lylemoffitt/Sr-Design/Project Materials/Media/CAD Final Moc.png

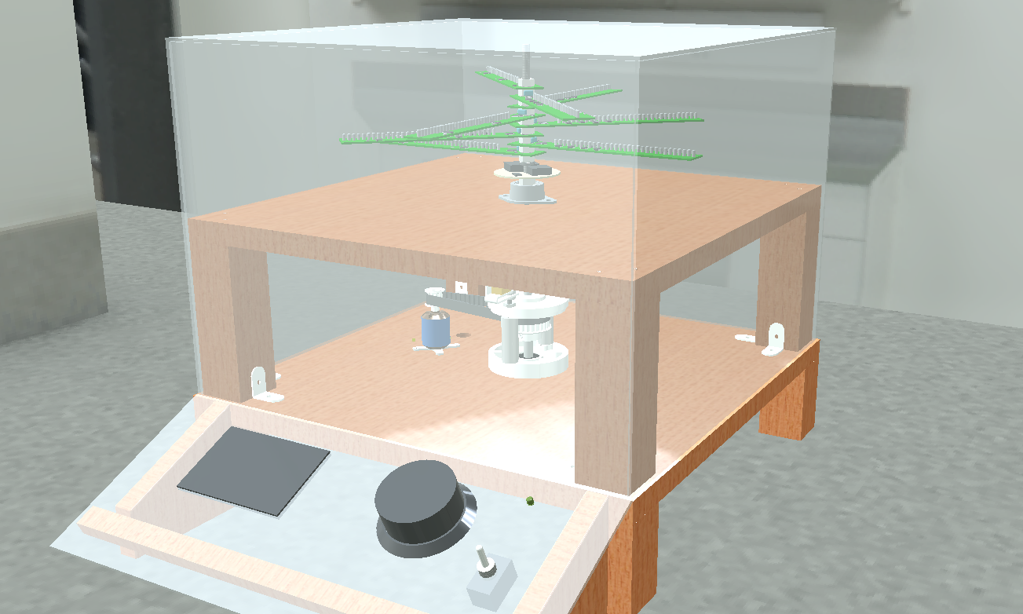
Project Materials/Media/CAD Final Moc.png
