lylemoffitt/Sr-Design/Project Materials/Media/CAD Moc.png

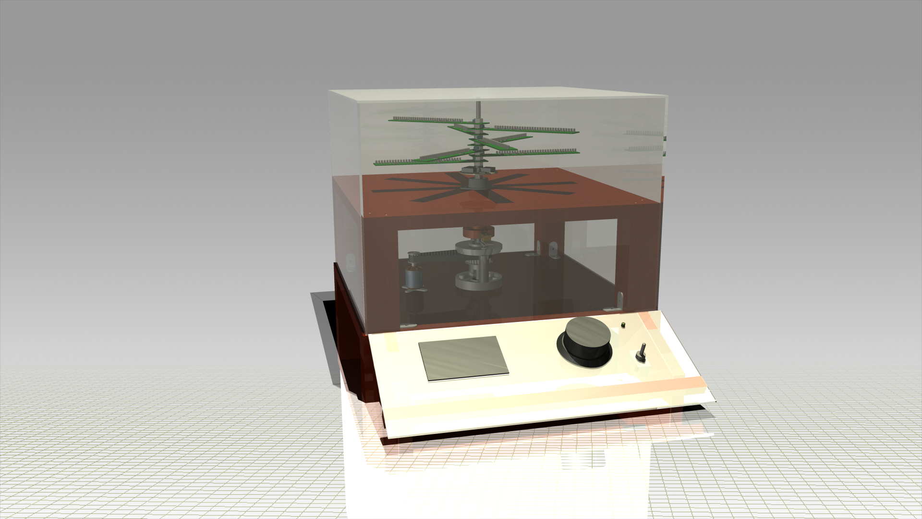
Project Materials/Media/CAD Moc.png
