lylemoffitt/Sr-Design/Project Materials/Planning Materials/Senior Design - Item Priority Check List.xlsx

 | Item | Priority | Time Frame | Decision | Notes
 | New Power Electronics | Medium | Soon
 | 40A ESC | Low | Done
 | New Hall Effect Sensor | Medium | Soon
PCB | Finalize Schematic [on paper] | High | ASAP
 | Arduino - Built in vs. not | High | Soon | TBD
LEDs | Number of (16,32,48) | Low | Done | 32 | Need to Consider Power Draw - We do have a 12V, 6A supply available in lab
 | Type of | Low | Done | 3mm T-H
 | Number of z-layers | Low | Done | 8
 | Refine/clean/neaten platform | Low | Far Away
 | Plexiglass enclosure | High | Far Away
 | Mechanical Tweaks/Fixes | Medium | As Necessary
 | On board SD-Card | Low | Done | No
 | Wireless Communication | Low | Done | No
 | On board EEPROM | High | Soon | Probs
