lylemoffitt/Sr-Design/Project Materials/Documentation Materials/Proposal Outline.jpg

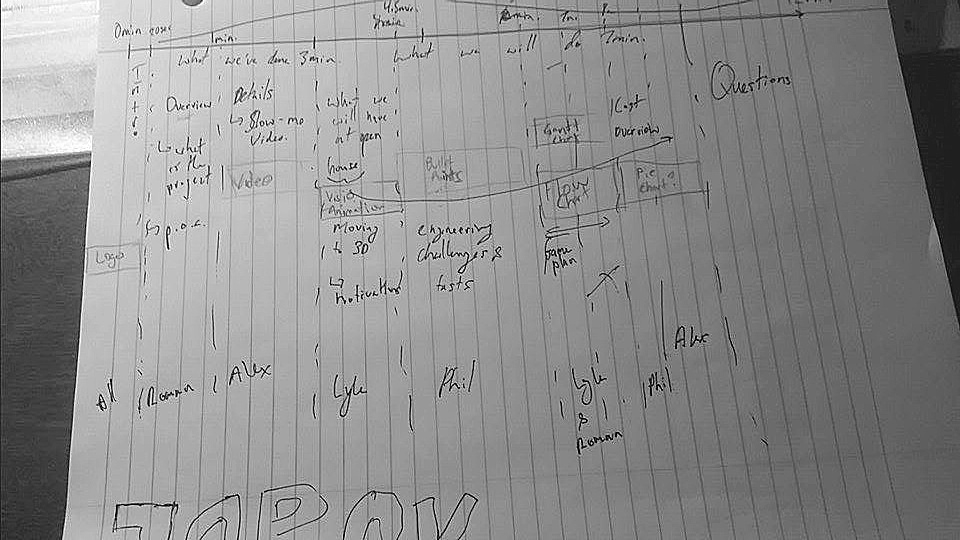
Project Materials/Documentation Materials/Proposal Outline.jpg
