lylemoffitt/Sr-Design/Project Materials/Reference Materials/LED wing schematic.png

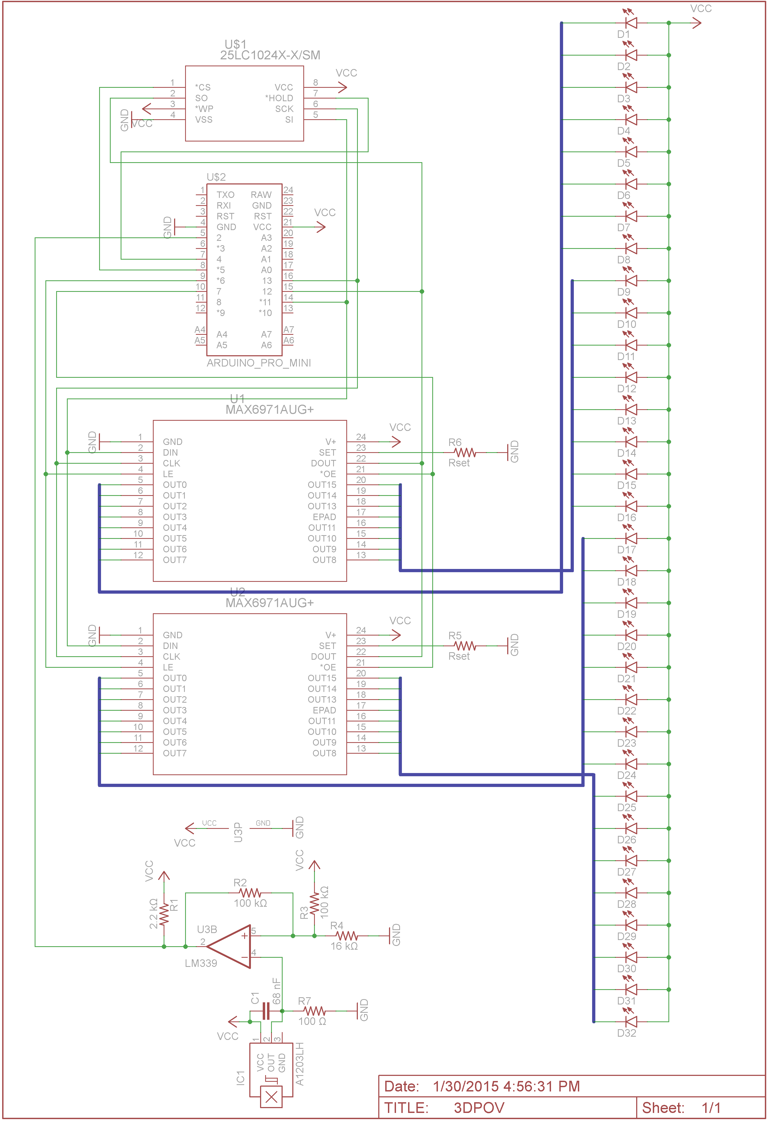
Project Materials/Reference Materials/LED wing schematic.png
