lylemoffitt/Sr-Design/Project Materials/Reference Materials/Schematic.png

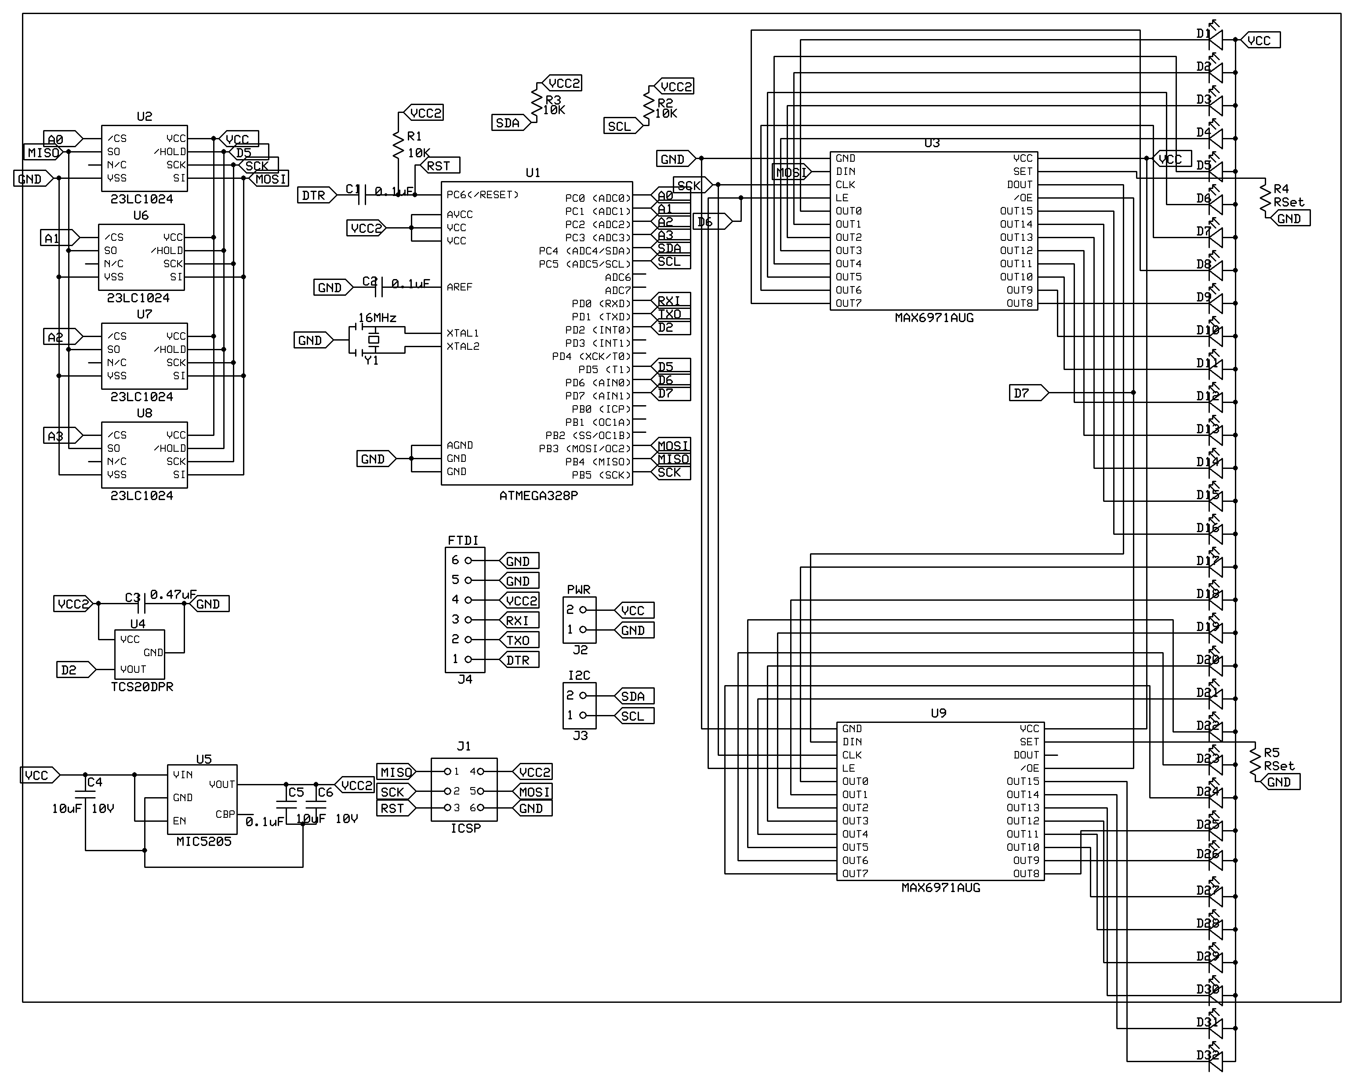
Project Materials/Reference Materials/Schematic.png
