lylemoffitt/Sr-Design/Project Materials/Documentation Materials/DataFlow.pptx

Import Source
Slice
Tool: Slic3r
Rasterize
Tool: Ghostscript
Source: Online
Type: application/vnd.ms-pki.stl
Type: image/svg+xml
Type: application/vnd.cups-raster
Transform
Cartesian to Polar
Scale resolution
Type: application/octet-stream
Transfer
SPI over RF
I2C to blades

Interrupt Source
Hardware Timer
Hall-Effect
I2C Tx/Rx
Reset Timer
Load Buffer From SRAM
Print LEDs From Buffer
Change SRAM Source
Load To SRAM
SPI Tx/Rx
Load SRAM
I2C Transfer
