lylemoffitt/Sr-Design/Project Materials/Planning Materials/ELE 491 Order Form.xlsx

Sheet: Sheet1
 |  | Group 3: Roman O., Alex J., Philip G., Lyle M.
 |  | ELE 491
 |  | 2014-10-15
 |  | Company website (http://www.digikey.com/)
 |  | McMastercarr.com
Number | Quantity | Part # | Part name | Cost | Sub Total
1 | 1 | 8312K72 | Super-Conductive 101 Copper | $35.24 | $35.24
 |  |  |  | Total | $35.24
 |  | Company website (http://www.digikey.com/)
 |  | Hobbyking.com
Number | Quantity | Part # | Part name | Cost | Sub Total
1 | 1 | D2836-11750 | Turnigy D2836/11 750KV Brushless Outrunner Motor | $13.40 | $13.40
 |  |  |  | Total | $13.40
 |  | Company website (http://www.digikey.com/)
 |  | sdp-si.com
Number | Quantity | Part # | Part name | Cost | Sub Total
1 | 1 | A 6A35M010DF1004 | 5 mm (T5) Pitch,10 Teeth, 4mm Bore, 2 Flanges/With Hub, Aluminum Alloy Timing Pulley for 10mm Wide Belt | $8.60 | $8.60
2 | 1 | A 6A55-026DF1512 | 5 mm (GT2) Pitch,26 Teeth, 0.375" Bore, 2 Flanges / With Hub, Aluminum Alloy Timing Pulley for .591 (15mm)" Wide Belt | $15.07 | $15.07
3 | 2 | A 6T35M061100 | 5 mm (T5) Pitch, 61 Teeth, 10mm wide Single Sided Polyurethane Belt with Steel Tensile Cords | $5.45 | $10.90
 |  |  |  | Total | $34.57
 |  | Company website
 |  | digikey.com
Number | Quantity | Part # | Part name | Cost | Sub Total
1 | 4 | MAX6971ANG+-ND (http://www.digikey.com/product-detail/en/MAX6971ANG%2B/MAX6971ANG%2B-ND/1512074) | 16-Port, 36V Constant-Current LED Driver | $5.25 | $21.00
 |  |  |  | Total | $21.00
 |  |  |  | Grand Total | $104.21

Sheet: Sheet2
 | Request for reimbursement
You need to get approval prior to purchasing, Use this form with updated prices to get reimbursted
 | Date: | Company: | Approved By:
 | 2014-02-05 | Midnight Electronics
 |  |  |  | Estimated
Number | Quantity | Part # | Part name | Cost | Sub Total
1
2 |  |  |  |  | $0.00
3 |  |  |  |  | $0.00
4 |  |  |  |  | $0.00
5 |  |  |  |  | $0.00
6 |  |  |  |  | $0.00
7 |  |  |  |  | $0.00
8 |  |  |  |  | $0.00
9 |  |  |  |  | $0.00
10 |  |  |  |  | $0.00
11 |  |  |  |  | $0.00
12 |  |  |  |  | $0.00
13 |  |  |  |  | $0.00
14 |  |  |  |  | $0.00
15 |  |  |  |  | $0.00
16 |  |  |  |  | $0.00
 |  |  |  |  | $0.00
 |  |  |  |  | $0.00
 |  |  | Estimated | Total | $0.00
