lylemoffitt/Sr-Design/Project Materials/Planning Materials/ELE 492 Order Form.xlsx

Sheet: Sheet1
 |  | Group 3: Roman O., Alex J., Philip G., Lyle M.
 |  | ELE 492
 |  | Feb-13-2015
 |  | Company website (http://www.digikey.com/)
 |  | mcmaster-carr.com
Number | Quantity | Part # | Part name | Cost | Sub Total
1 | 4 | 8560K257 (http://www.mcmaster.com/) | Optically Clear Cast Acrylic Sheet, 1/8" Thick, 12" x 24" | $15.76 | $63.04
2 | 1 | 8560K259 (http://www.mcmaster.com/) | Optically Clear Cast Acrylic Sheet, 1/8" Thick, 24" x 24" | $23.21 | $23.21
 |  |  |  | Total | $86.25
 |  | Company website (http://www.digikey.com/)
 |  | mpja.com
Number | Quantity | Part # | Part name | Cost | Sub Total
1 | 6 | 15105 OP | 3mm White LED, Non Diffused | $2.95 | $17.70
 |  |  |  | Total | $17.70
 |  | Company website
 |  | digikey.com
Number | Quantity | Part # | Part name | Cost | Sub Total
1 | 36 | MAX6971AUG+-ND (http://www.digikey.com/product-detail/en/MAX6971ANG%2B/MAX6971ANG%2B-ND/1512074) | 16-Port, 36V Constant-Current LED Driver | $3.64 | $131.04
2 | 25 | TCS20DPRLF(TCT-ND (http://www.digikey.com/scripts/DkSearch/dksus.dll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) | Toshiba Digital Hall Effect Sensor | $0.31 | $7.70
3 | 72 | 23LC1024-I/SN-ND (http://www.digikey.com/scripts/DkSearch/dksus.dll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) | IC SRAM 1MBIT 20MHZ 8SOIC | $2.02 | $145.44
4 | 25 | ATMEGA328P-AURCT-ND (http://www.digikey.com/scripts/DkSearch/dksus.dll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) | IC MCU 8BIT 32KB FLASH 32TQFP | $3.10 | $77.45
5 | 25 | 490-5999-1-ND (http://www.digikey.com/scripts/DkSearch/dksus.dll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) | CER RESONATOR | $0.35 | $8.77
6 | 25 | 576-1261-1-ND (http://www.digikey.com/scripts/DkSearch/dksus.dll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) | IC REG LDO 5V 0.15A SOT23-5 | $0.52 | $12.88
 |  |  |  | Total | $383.28
 |  |  |  | Grand Total | $487.23

Sheet: Sheet2
 | Request for reimbursement
You need to get approval prior to purchasing, Use this form with updated prices to get reimbursted
 | Date: | Company: | Approved By:
 | 2014-02-05 | Midnight Electronics
 |  |  |  | Estimated
Number | Quantity | Part # | Part name | Cost | Sub Total
1
2 |  |  |  |  | $0.00
3 |  |  |  |  | $0.00
4 |  |  |  |  | $0.00
5 |  |  |  |  | $0.00
6 |  |  |  |  | $0.00
7 |  |  |  |  | $0.00
8 |  |  |  |  | $0.00
9 |  |  |  |  | $0.00
10 |  |  |  |  | $0.00
11 |  |  |  |  | $0.00
12 |  |  |  |  | $0.00
13 |  |  |  |  | $0.00
14 |  |  |  |  | $0.00
15 |  |  |  |  | $0.00
16 |  |  |  |  | $0.00
 |  |  |  |  | $0.00
 |  |  |  |  | $0.00
 |  |  | Estimated | Total | $0.00
