lylemoffitt/Sr-Design/Project Materials/3DPOV Eagle BoardFiles/3DPOV_PANEL.bmp

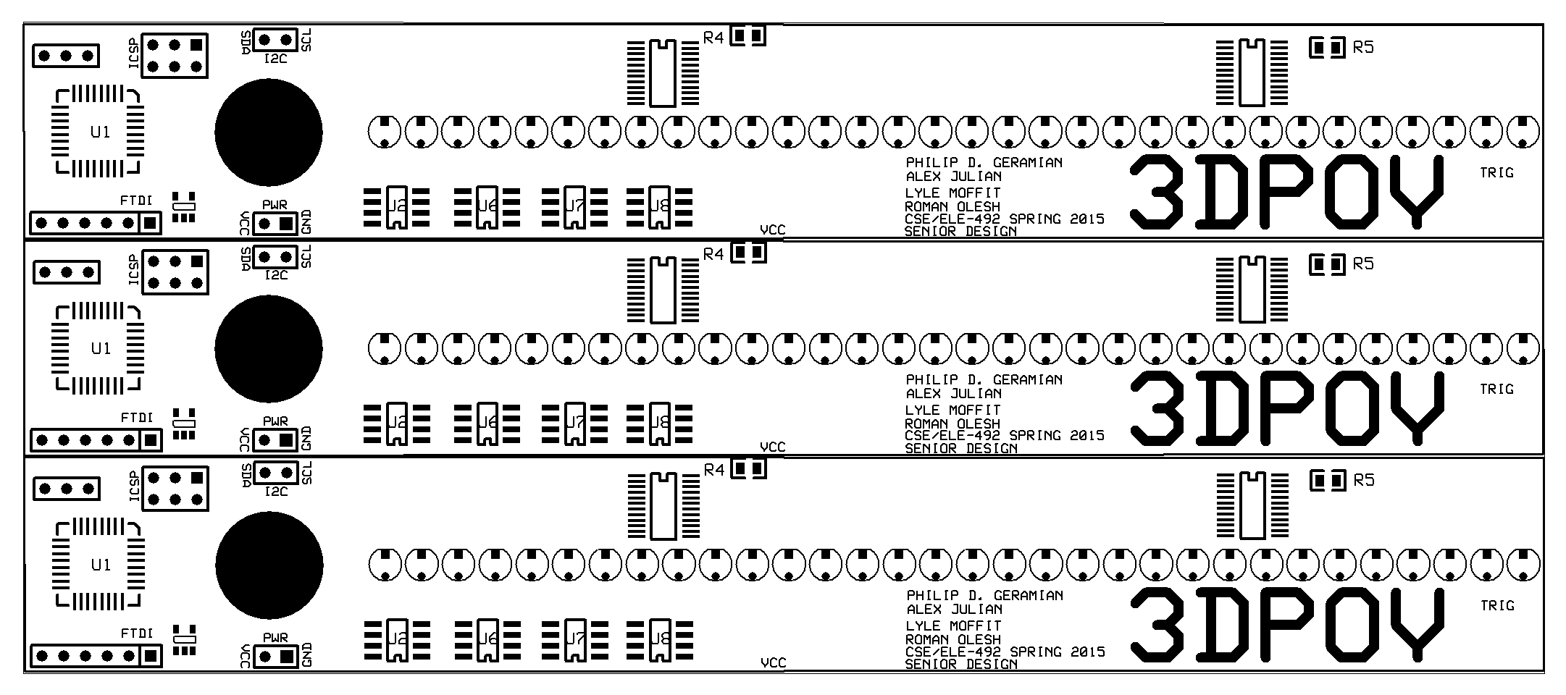
Project Materials/3DPOV Eagle BoardFiles/3DPOV_PANEL.bmp
