lylemoffitt/Sr-Design/Project Materials/Media/BackEnd DataFlow.png

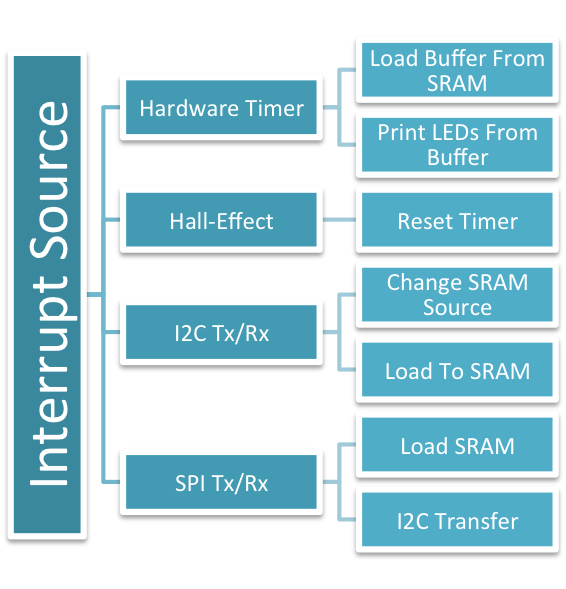
Project Materials/Media/BackEnd DataFlow.png
