lylemoffitt/Sr-Design/Project Materials/Media/FrontEnd DataFlow.png

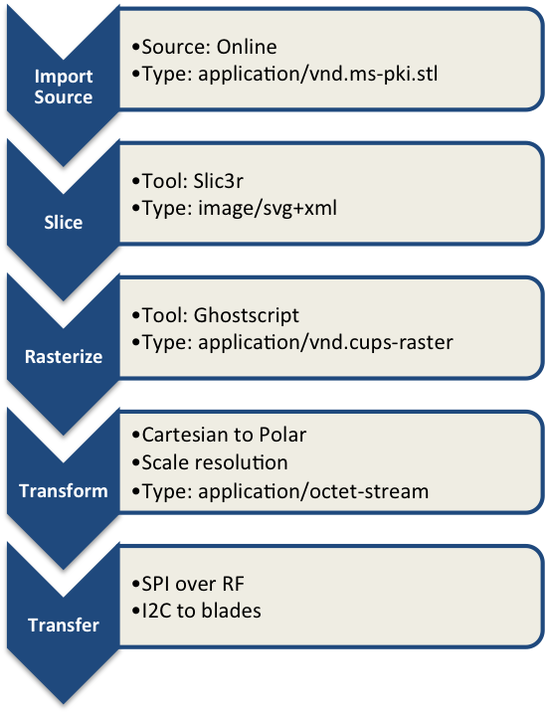
Project Materials/Media/FrontEnd DataFlow.png
