lylemoffitt/Sr-Design/Project Materials/Media/Layering Example.png

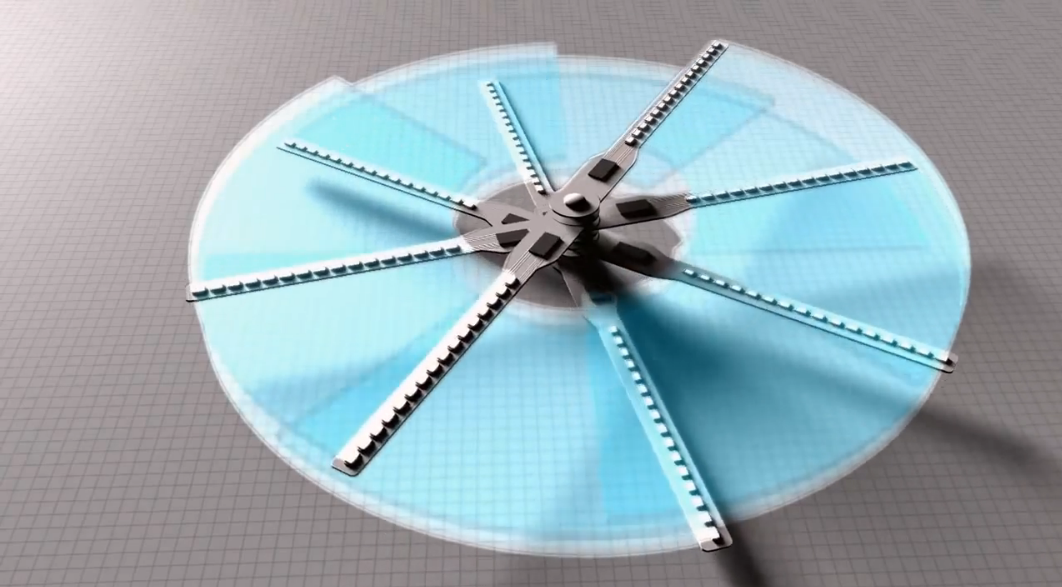
Project Materials/Media/Layering Example.png
