lylemoffitt/Sr-Design/Project Materials/Media/OpenHouse 1.JPG

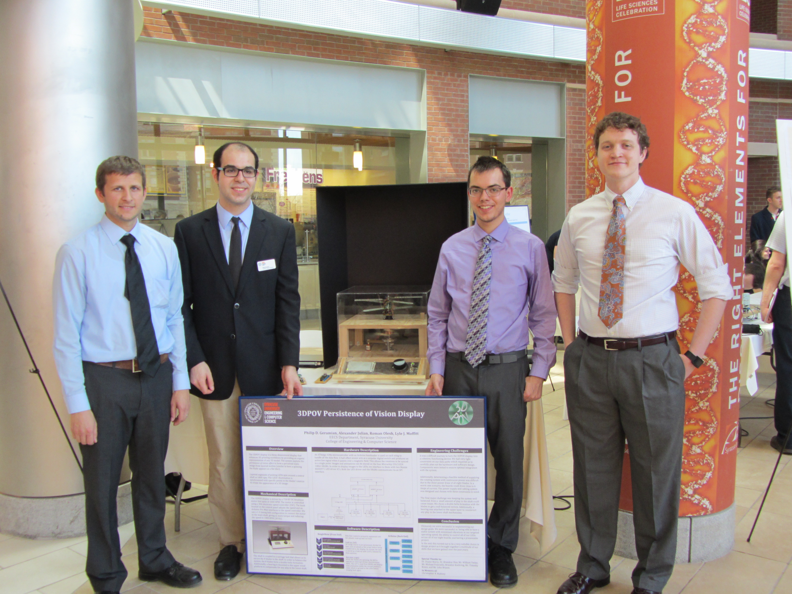
Project Materials/Media/OpenHouse 1.JPG
