lylemoffitt/Sr-Design/Project Materials/Media/OpenHouse 2.JPG

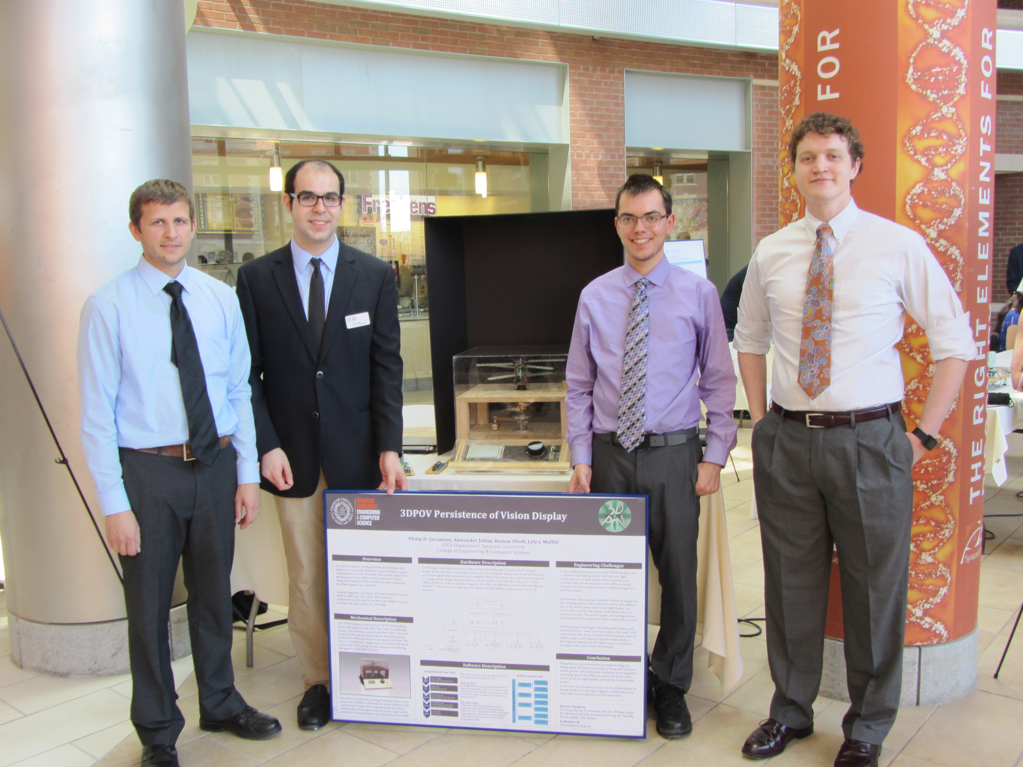
Project Materials/Media/OpenHouse 2.JPG
