lylemoffitt/Sr-Design/Project Materials/Media/OpenHouse 3.JPG

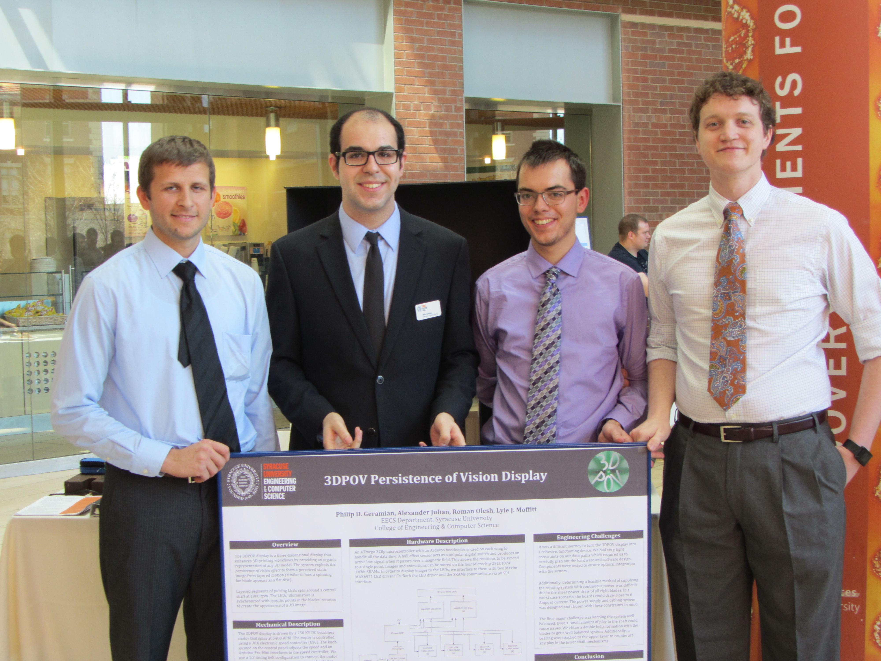
Project Materials/Media/OpenHouse 3.JPG
