lylemoffitt/Sr-Design/Project Materials/Media/OpenHouse 4.JPG

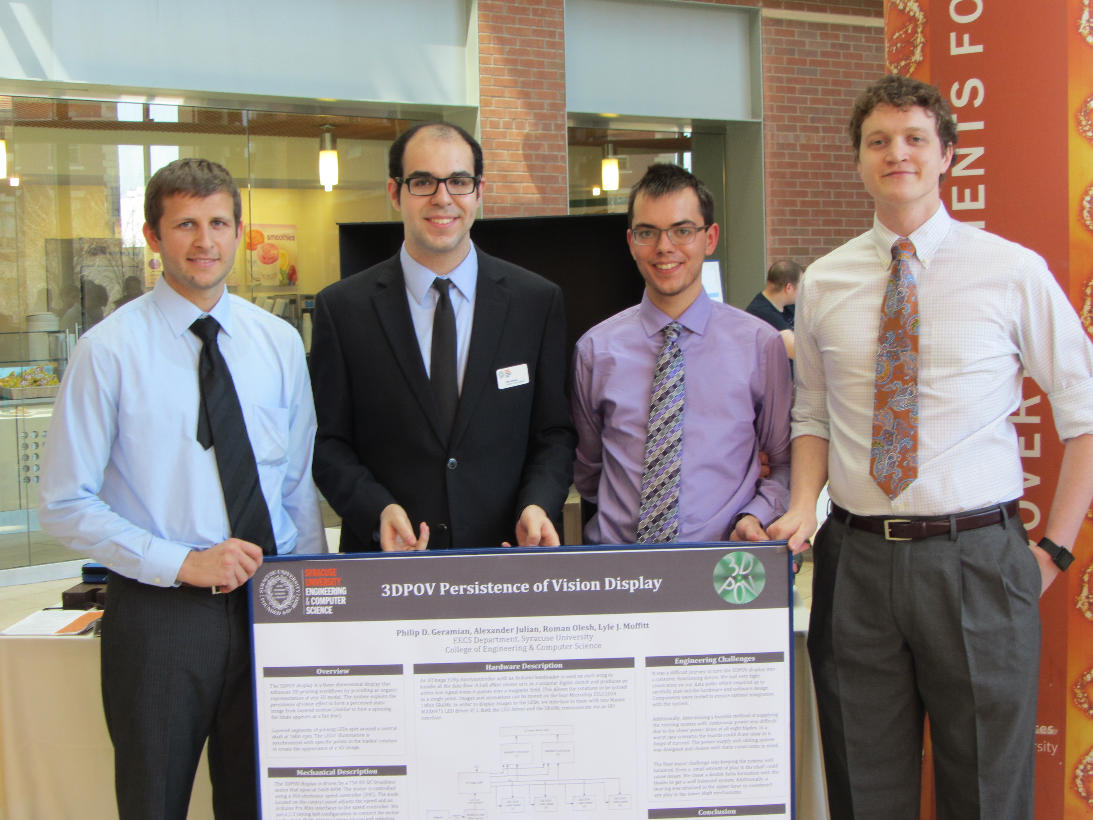
Project Materials/Media/OpenHouse 4.JPG
