lylemoffitt/Sr-Design/Project Materials/Media/Prototype Static.png

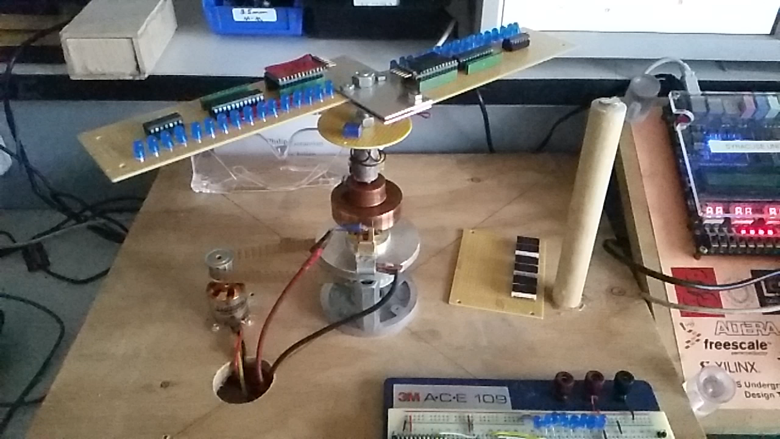
Project Materials/Media/Prototype Static.png
