lylemoffitt/Sr-Design/Project Materials/Reference Materials/Polah.jpg

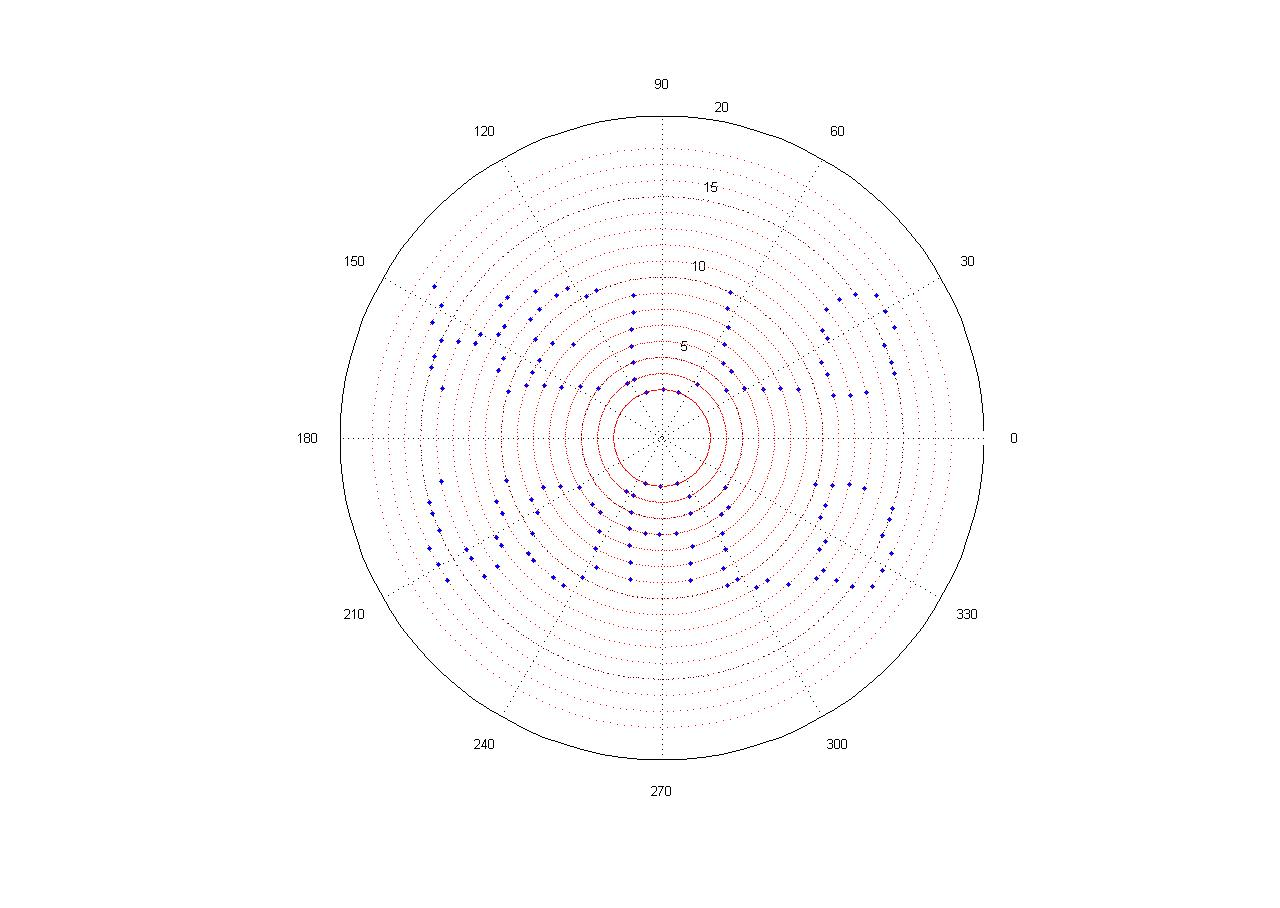
Project Materials/Reference Materials/Polah.jpg
