lylemoffitt/Sr-Design/Project Materials/3DPOV Eagle BoardFiles/3DPOV_PANEL.dxf

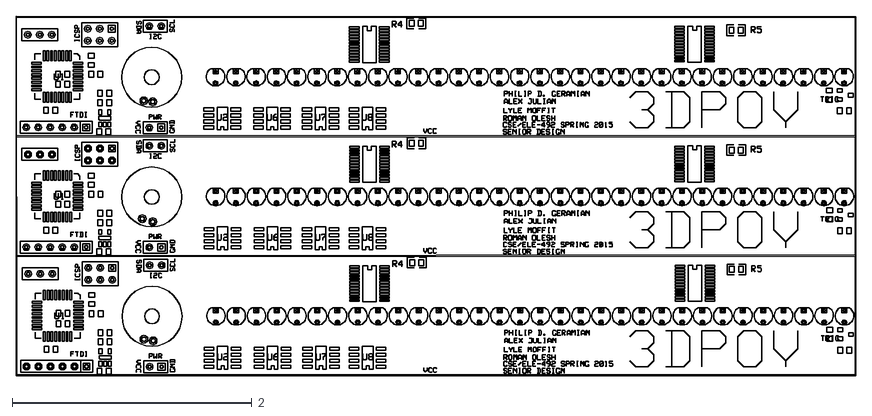
[picture p55: CAD file, 2015-09-22]
Project Materials/3DPOV Eagle BoardFiles/3DPOV_PANEL.dxf
7.00 x 3.00
