lylemoffitt/Sr-Design/Project Materials/Reference Materials/Bearing Shim Diagram.pdf

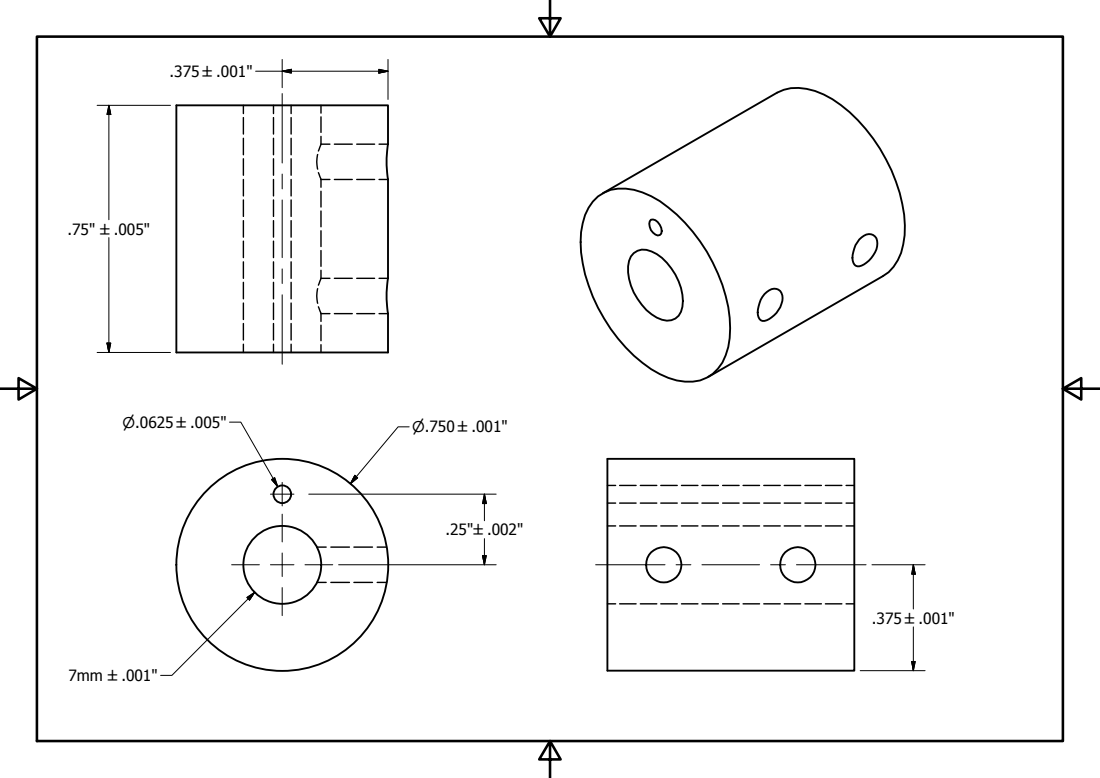
[picture p56: page 1]
