lylemoffitt/Sr-Design/(list of files, drawings)

Other design files:
Project Materials/3DPOV Eagle BoardFiles/3DPOV.pcb
Project Materials/3DPOV Eagle BoardFiles/3DPOV_PANEL.pcb
Project Materials/3DPOV Eagle BoardFiles/EXPRESSPCB/3DPOV_rev2.pcb
