lylemoffitt/Sr-Design/Project Materials/3DPOV Eagle BoardFiles/3DPOV (Alex Julian's conflicted copy 2015-02-14).sch

## EAGLE design Project Materials/3DPOV Eagle BoardFiles/3DPOV (Alex Julian's conflicted copy 2015-02-14).sch (2015-09-22)

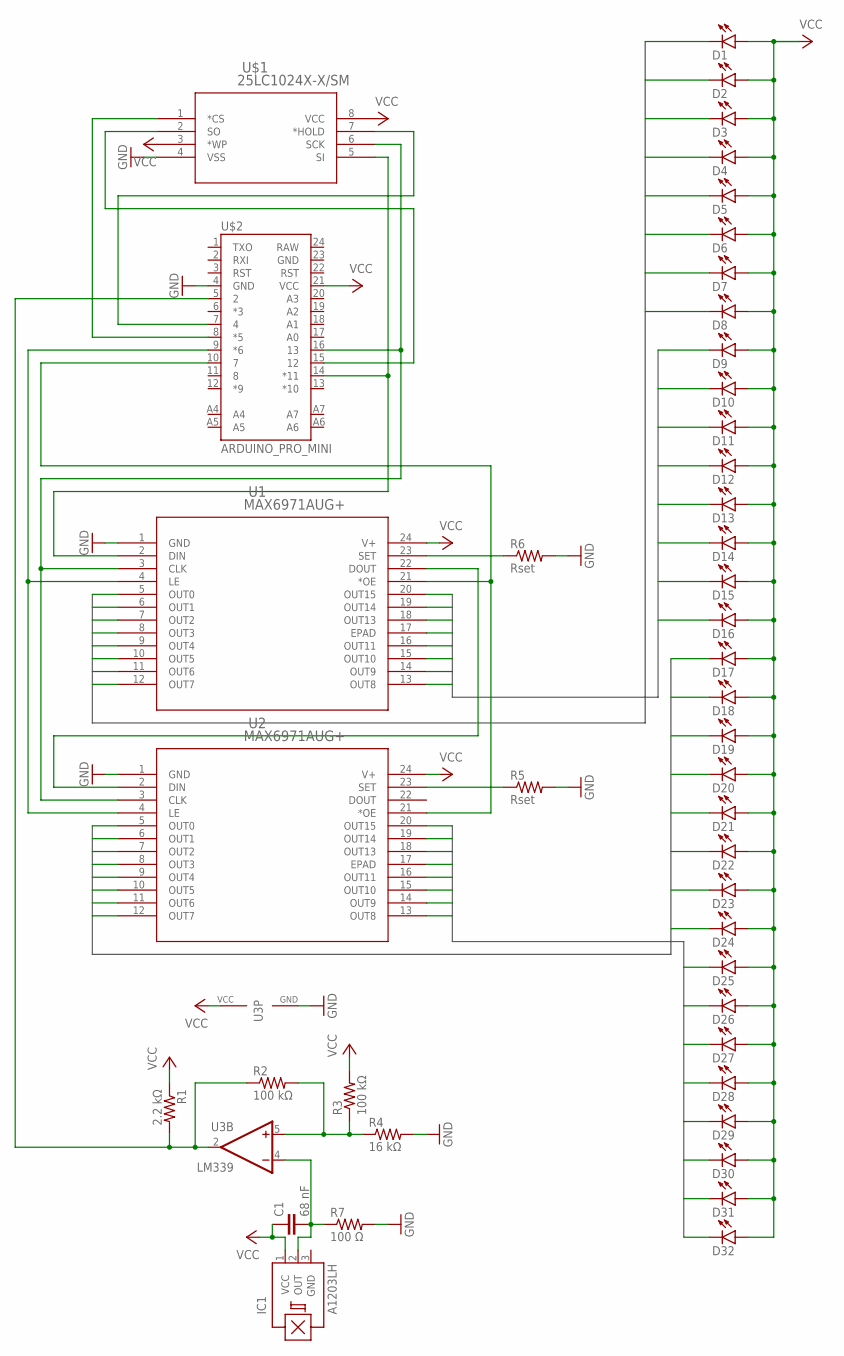
[picture p57: schematic 3DPOV (Alex Julian's conflicted copy 2015-02-14).sch]

Parts:
C1: 68 nF; C2.5-3
D1, D2, D3, D4, D5, D6, D7, D8, D9, D10, D11, D12, D13, D14, D15, D16, D17, D18, D19, D20, D21, D22, D23, D24, D25, D26, D27, D28, D29, D30, D31, D32: LED3MM
IC1: A1203LH; SOT23-W
R1: 2.2 kΩ; 0204/7
R2, R3: 100 kΩ; 0204/7
R4: 16 kΩ; 0204/7
R5, R6: Rset; 0204/7
R7: 100 Ω; 0204/7
U1, U2: MAX6971AUG+; 21-0066J_24
U3: LM339; TSSOP-14
U$1: 25LC1024X-X/SM; SOIJ8-M_MC
U$2: ARDUINO_PRO_MINI

Connections:
GND: R4.2, R5.2, R6.2, R7.2, U1.1 (GND), U2.1 (GND), U3.12 (GND), U$1.4 (VSS), U$2.4 (GND)
LEDA0: D1.K (C), U1.5 (OUT0)
LEDA1: D2.K (C), U1.6 (OUT1)
LEDA2: D3.K (C), U1.7 (OUT2)
LEDA3: D4.K (C), U1.8 (OUT3)
LEDA4: D5.K (C), U1.9 (OUT4)
LEDA5: D6.K (C), U1.10 (OUT5)
LEDA6: D7.K (C), U1.11 (OUT6)
LEDA7: D8.K (C), U1.12 (OUT7)
LEDB0: D9.K (C), U1.13 (OUT8)
LEDB1: D10.K (C), U1.14 (OUT9)
LEDB2: D11.K (C), U1.15 (OUT10)
LEDB3: D12.K (C), U1.16 (OUT11)
LEDB4: D13.K (C), U1.17 (EPAD)
LEDB5: D14.K (C), U1.18 (OUT13)
LEDB6: D15.K (C), U1.19 (OUT14)
LEDB7: D16.K (C), U1.20 (OUT15)
LEDC0: D17.K (C), U2.5 (OUT0)
LEDC1: D18.K (C), U2.6 (OUT1)
LEDC2: D19.K (C), U2.7 (OUT2)
LEDC3: D20.K (C), U2.8 (OUT3)
LEDC4: D21.K (C), U2.9 (OUT4)
LEDC5: D22.K (C), U2.10 (OUT5)
LEDC6: D23.K (C), U2.11 (OUT6)
LEDC7: D24.K (C), U2.12 (OUT7)
LEDD0: D25.K (C), U2.13 (OUT8)
LEDD1: D26.K (C), U2.14 (OUT9)
LEDD2: D27.K (C), U2.15 (OUT10)
LEDD3: D28.K (C), U2.16 (OUT11)
LEDD4: D29.K (C), U2.17 (EPAD)
LEDD5: D30.K (C), U2.18 (OUT13)
LEDD6: D31.K (C), U2.19 (OUT14)
LEDD7: D32.K (C), U2.20 (OUT15)
unnamed: R6.1, U1.23 (SET)
unnamed: R5.1, U2.23 (SET)
unnamed: U1.2 (DIN), U$1.5 (SI), U$2.14 (*11)
unnamed: U1.22 (DOUT), U2.2 (DIN)
unnamed: R2.2, R3.1, R4.1, U3.5 (+IN)
unnamed: U$1.2 (SO), U$2.15 (12)
unnamed: R1.2, R2.1, U3.2 (OUT), U$2.5 (2)
unnamed: U1.3 (CLK), U2.3 (CLK), U$1.6 (SCK), U$2.16 (13)
unnamed: U1.21 (*OE), U2.21 (*OE), U$2.10 (7)
unnamed: U1.4 (LE), U2.4 (LE), U$2.9 (*6)
unnamed: U$1.7 (*HOLD), U$2.7 (4)
unnamed: C1.2, IC1.2 (OUT), R7.1, U3.4 (-IN)
unnamed: U$1.1 (*CS), U$2.8 (*5)
VCC: C1.1, D1.A, D2.A, D3.A, D4.A, D5.A, D6.A, D7.A, D8.A, D9.A, D10.A, D11.A, D12.A, D13.A, D14.A, D15.A, D16.A, D17.A, D18.A, D19.A, D20.A, D21.A, D22.A, D23.A, D24.A, D25.A, D26.A, D27.A, D28.A, D29.A, D30.A, D31.A, D32.A, IC1.1 (VCC), R1.1, R3.2, U1.24 (V+), U2.24 (V+), U3.3 (VCC), U$1.3 (*WP), U$1.8 (VCC), U$2.21 (VCC)
