lylemoffitt/Sr-Design/Project Materials/3DPOV Eagle BoardFiles/Arduino-Pro-Mini.sch

## EAGLE design Project Materials/3DPOV Eagle BoardFiles/Arduino-Pro-Mini.sch (2015-09-22)

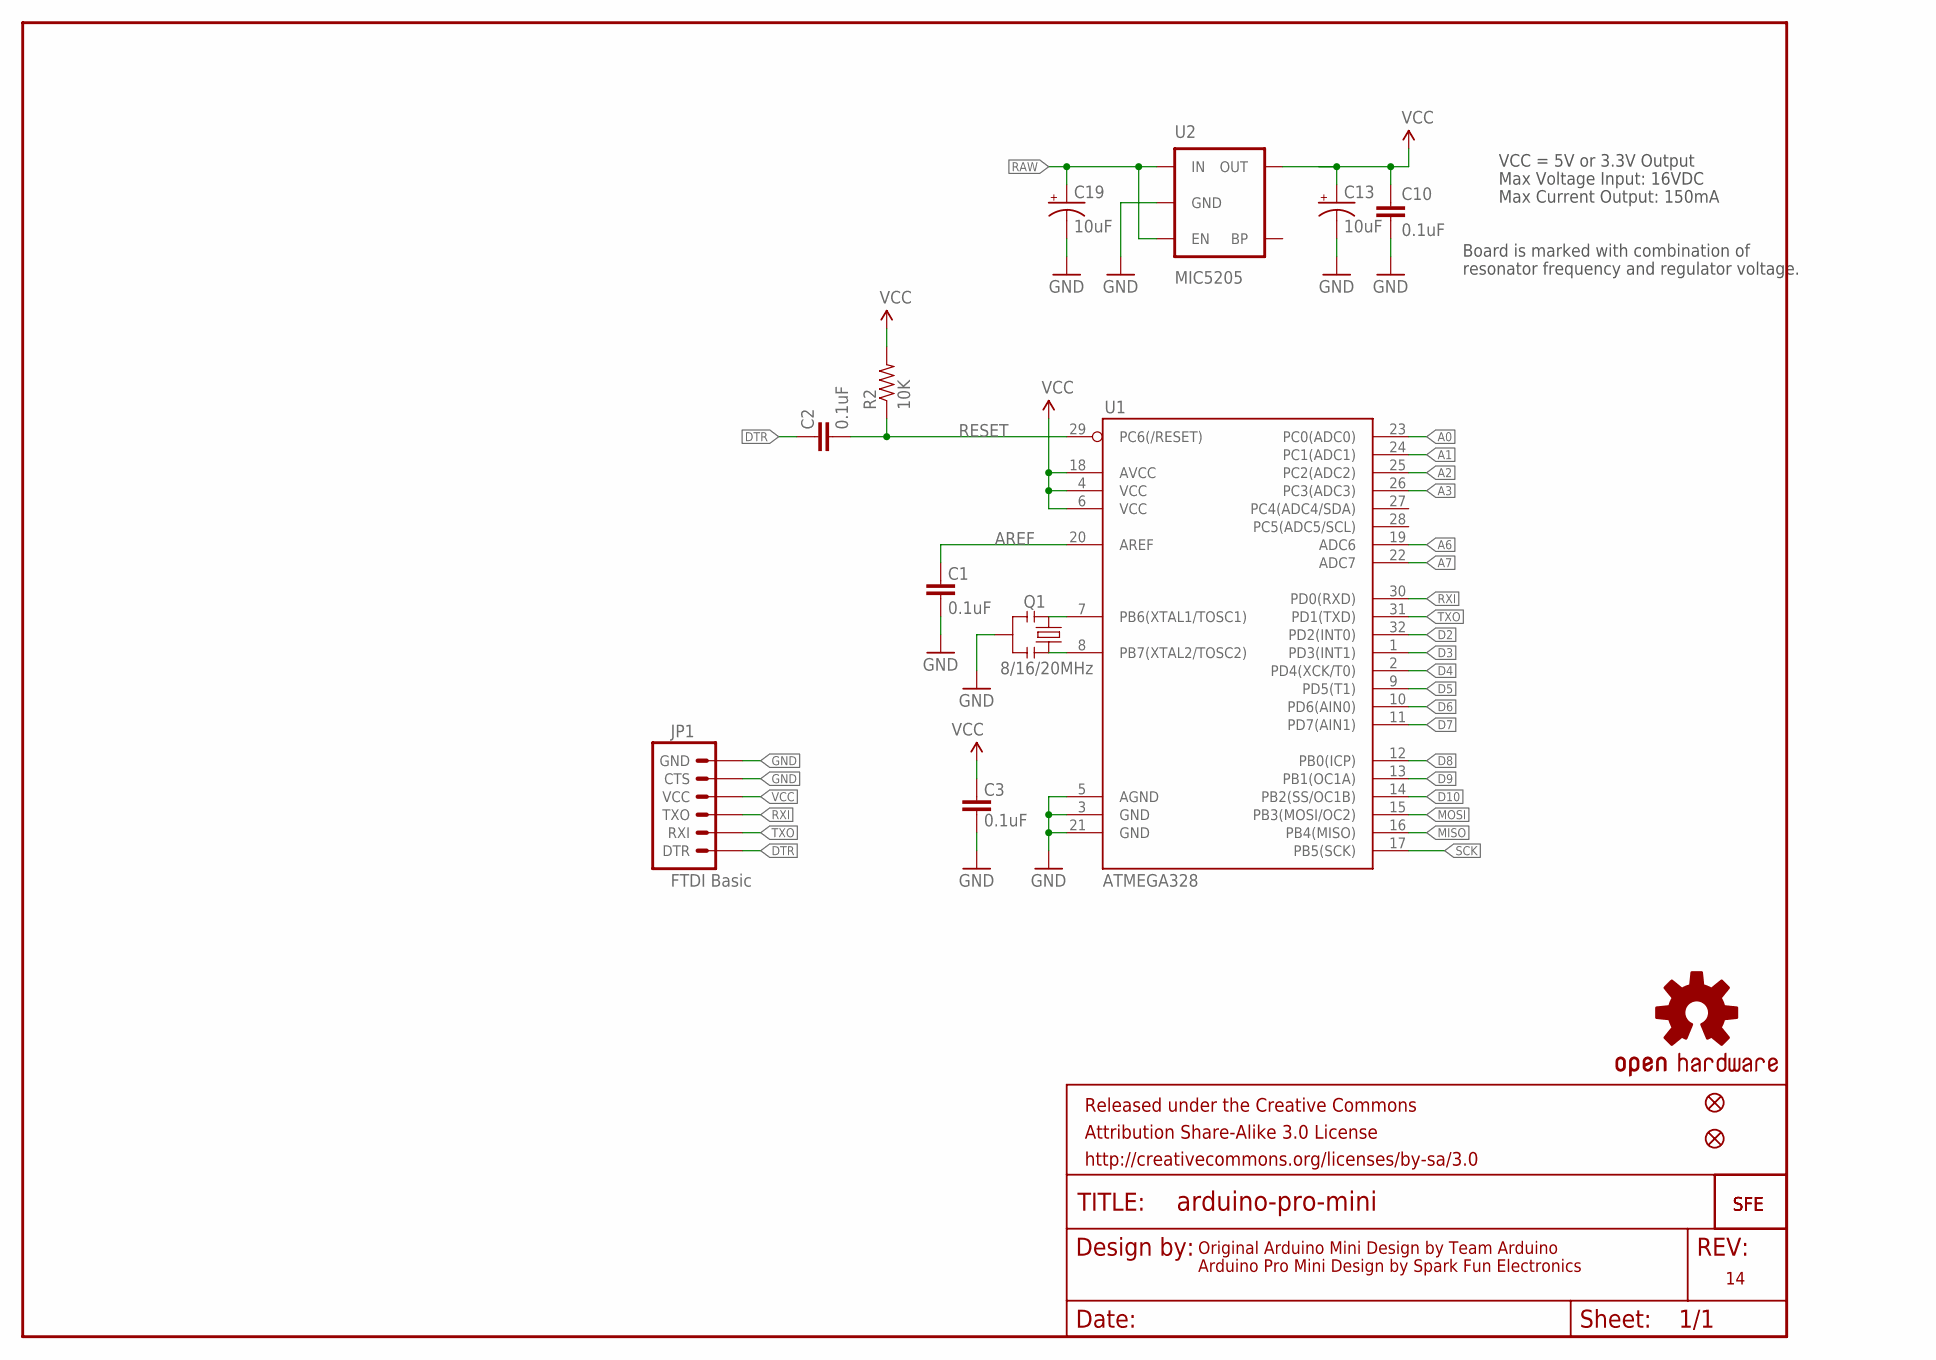
[picture p58: schematic Arduino-Pro-Mini.sch]

Parts:
C1, C2, C3, C10: 0.1uF; 0603-CAP
C13, C19: 10uF; EIA3216
FRAME1: FRAME-LETTER; CREATIVE_COMMONS
JP1: FTDI Basic; 1X06
JP5, JP8: FIDUCIALUFIDUCIAL; MICRO-FIDUCIAL
Q1: 8/16/20MHz; RESONATOR-SMD-1:1
R2: 10K; 0603-RES
U1: ATMEGA328; TQFP32-08
U2: MIC5205; SOT23-5
U$1: LOGO-SFESK; SFE-LOGO-FLAME
U$3: OSHW-LOGOS; OSHW-LOGO-S
U$11: LOGO-SFENEW; SFE-NEW-WEBLOGO

Connections:
A0: U1.23 (PC0(ADC0))
A1: U1.24 (PC1(ADC1))
A2: U1.25 (PC2(ADC2))
A3: U1.26 (PC3(ADC3))
A6: U1.19 (ADC6)
A7: U1.22 (ADC7)
AREF: C1.2, U1.20 (AREF)
D2: U1.32 (PD2(INT0))
D3: U1.1 (PD3(INT1))
D4: U1.2 (PD4(XCK/T0))
D5: U1.9 (PD5(T1))
D6: U1.10 (PD6(AIN0))
D7: U1.11 (PD7(AIN1))
D8: U1.12 (PB0(ICP))
D9: U1.13 (PB1(OC1A))
D10: U1.14 (PB2(SS/OC1B))
DTR: C2.2, JP1.1 (DTR)
GND: C1.1, C3.1, C10.2, C13.C (-), C19.C (-), JP1.5 (CTS), JP1.6 (GND), Q1.2, U1.3 (GND), U1.5 (AGND), U1.21 (GND), U2.2 (GND)
MISO: U1.16 (PB4(MISO))
MOSI: U1.15 (PB3(MOSI/OC2))
unnamed: Q1.3, U1.8 (PB7(XTAL2/TOSC2))
unnamed: Q1.1, U1.7 (PB6(XTAL1/TOSC1))
RAW: C19.A (+), U2.1 (IN), U2.3 (EN)
RESET: C2.1, R2.1, U1.29 (PC6(/RESET))
RXI: JP1.3 (TXO), U1.30 (PD0(RXD))
SCK: U1.17 (PB5(SCK))
TXO: JP1.2 (RXI), U1.31 (PD1(TXD))
VCC: C3.2, C10.1, C13.A (+), JP1.4 (VCC), R2.2, U1.4 (VCC), U1.6 (VCC), U1.18 (AVCC), U2.5 (OUT)

Notes on the sheet:
Original Arduino Mini Design by Team Arduino
Arduino Pro Mini Design by Spark Fun Electronics
Max Voltage Input: 16VDC
Max Current Output: 150mA
Board is marked with combination of
resonator frequency and regulator voltage.
VCC = 5V or 3.3V Output
