lylemoffitt/Sr-Design/Project Materials/Arduino Programming Materials/DUKE_NUKEM/NUKE_1/NUKE_1.ino

// include the SPI library:
#include <SPI.h>

struct fin { byte msb1,lsb1,msb2,lsb2; };
byte check = 0;
const static fin dat[] = 
{
  {0xFF,0xFF,0xFF,0xFF},{0xFF,0xFF,0xFF,0xFF},{0xFF,0xFF,0xFF,0xFF},{0xFF,0xFF,0xFF,0xFF},{0xFF,0xFF,0xFF,0xFF},{0xFF,0xFF,0xFF,0xFF},{0xFF,0xFF,0xFF,0xFF},{0xFF,0xFF,0xFF,0xFF},
  {0xFF,0xFF,0xFF,0xFF},{0xFF,0xFF,0xFF,0xFF},{0xFF,0xFF,0xFF,0xFF},{0xFF,0xFF,0xFF,0xFF},{0xFF,0xFF,0xFF,0xFF},{0xFF,0xFF,0xFF,0xFF},{0xFF,0xFF,0xFF,0xFF},{0xFF,0xFF,0xFF,0xFF},
  {0xFF,0xFF,0xFF,0xFF},{0xFF,0xFF,0xFF,0xFF},{0xFF,0xFF,0xFF,0xFF},{0xFF,0xFF,0xFF,0xFF},{0xFF,0xFF,0xFF,0xFF},{0xFF,0xFF,0xFF,0xFF},{0xFF,0xFF,0xFF,0xFF},{0xFF,0xFF,0xFF,0xFF},
  {0xFF,0xFF,0xFF,0xFF},{0xFF,0xFF,0xFF,0xFF},{0xFF,0xFF,0xFF,0xFF},{0xFF,0xFF,0xFF,0xFF},{0xFF,0xFF,0xFF,0xFF},{0xFF,0xFF,0xFF,0xFF},{0xFF,0xFF,0xFF,0xFF},{0xFF,0xFF,0xFF,0xFF},    
  {0xFF,0xFF,0xFF,0xFF},{0xFF,0xFF,0xFF,0xFF},{0xFF,0xFF,0xFF,0xFF},{0xFF,0xFF,0xFF,0xFF},{0xFF,0xFF,0xFF,0xFF},{0xFF,0xFF,0xFF,0xFF},{0xFF,0xFF,0xFF,0xFF},{0xFF,0xFF,0xFF,0xFF},
  {0xFF,0xFF,0xFF,0xFF},{0xFF,0xFF,0xFF,0xFF},{0x00,0x00,0x00,0x00},{0x00,0x00,0x00,0x00},{0x00,0x00,0x00,0x00},{0x00,0x00,0x00,0x00},{0x00,0x00,0x00,0x00},{0x00,0x00,0x00,0x00},
  {0x00,0x00,0x00,0x00},{0x00,0x00,0x00,0x00},{0x00,0x00,0x00,0x00},{0x00,0x00,0x00,0x00},{0x00,0x00,0x00,0x00},{0x00,0x00,0x00,0x00},{0x00,0x00,0x00,0x00},{0x00,0x00,0x00,0x00},
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
  {0x00,0x00,0x00,0x00},{0x00,0x00,0x00,0x00},{0x00,0x00,0x00,0x00},{0x00,0x00,0x00,0x00},{0x00,0x00,0x00,0x00},{0x00,0x00,0x00,0x00},{0x00,0x00,0x00,0x00},{0x00,0x00,0x00,0x00},
  {0x00,0x00,0x00,0x00},{0x00,0x00,0x00,0x00},{0x00,0x00,0x00,0x00},{0x00,0x00,0x00,0x00},{0x00,0x00,0x00,0x00},{0x00,0x00,0x00,0x00},{0x00,0x00,0x00,0x00},{0x00,0x00,0x00,0x00},
};

volatile unsigned i = 0;

void setup() {
  // Initialize I/O
  DDRC = DDRC | B0111111;
  DDRD = DDRD | B11111000;
  attachInterrupt(0,timing,FALLING);
  // initialize SPI:
  SPI.begin();
  SPI.setDataMode(SPI_MODE0);
  SPI.setClockDivider(SPI_CLOCK_DIV2);
  SPI.setBitOrder(MSBFIRST);
  
  PORTC = B0001111;
  PORTD = B10100000;
}

void loop() {
   
}

void timing(){
   //Runs when falling edge from Schmitt Trigger is seen
   check = digitalRead(2);   // This is mucho importante
   if(0 != check){
    return;  
   }
   for (i=96+128; i<256; i++) {
        LEDWrite();
   }
   for (i=0; i<96+128; i++) {
        LEDWrite();
   }
   PORTD = B10100000;
}

void LEDWrite() {
  PORTD = 0b10100000;
  SPI.transfer(dat[i].msb1);
  SPI.transfer(dat[i].lsb1);
  SPI.transfer(dat[i].msb2);
  SPI.transfer(dat[i].lsb2);
  PORTD = 0b11100000;
  //delayMicroseconds(59);
  PORTD = 0b00100000;
  delayMicroseconds(118); 
}
