lylemoffitt/Sr-Design/Project Materials/Arduino Programming Materials/Diamond/Diamond_1/Diamond_1.ino

// include the SPI library:
#include <SPI.h>

struct fin { byte outer,outer2,inner2,inner; };
byte check = 0;
const static fin dat[] = 
{
   //0b_0111_0000, 0b_0011_1000, 0b_0000_0000, 0b0000_0000
   //     7    0       3    8         0   0        0    0
 {0x00,0x00,0x00,0x00},//0
 {0x00,0x00,0x00,0x00},//1
 {0x00,0x00,0x00,0x00},//2
 {0x00,0x00,0x00,0x00},//3
 {0x00,0x00,0x00,0x00},//4
 {0x00,0x00,0x00,0x00},//5
 {0x00,0x00,0x00,0x00},//6
 {0x00,0x00,0x00,0x00},//7
 {0x00,0x00,0x00,0x00},//8
 {0x00,0x00,0x00,0x00},//9
 {0x00,0x00,0x00,0x00},//0
 {0x00,0x00,0x00,0x00},//11
 {0x00,0x00,0x00,0x00},//12
 {0x00,0x00,0x00,0x00},//13
 {0x00,0x00,0x00,0x00},//14
 {0x00,0x00,0x00,0x00},//15
 {0x00,0x00,0x00,0x00},//16
 {0x00,0x00,0x00,0x00},//17
 {0x00,0x00,0x00,0x00},//18
 {0x00,0x00,0x00,0x00},//19
 {0x00,0x00,0x00,0x00},//20
 {0x00,0x00,0x00,0x00},//21
 {0x00,0x00,0x00,0x00},//22
 {0x00,0x00,0x00,0x00},//23 
 {0x00,0x00,0x00,0x00},//24
 {0x00,0x00,0x00,0x00},//25
 {0x00,0x00,0x00,0x00},//26
 {0x00,0x00,0x00,0x00},//27
 {0x00,0x00,0x00,0x00},//28
 {0x00,0x00,0x00,0x00},//29
 {0x00,0x00,0x00,0x00},//30
 {0x00,0x00,0x00,0x00},//31  
 {0x00,0x00,0x00,0x00},//32
 {0x00,0x00,0x00,0x00},//33
 {0x00,0x00,0x00,0x00},//34
 {0x00,0x00,0x00,0x00},//35
 {0x00,0x00,0x00,0x00},//36
 {0x00,0x00,0x00,0x00},//37
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

};

volatile unsigned i = 0;

void setup() {
  // Initialize I/O
  DDRC = DDRC | B0111111;
  DDRD = DDRD | B11111000;
  attachInterrupt(0,timing,FALLING);
  // initialize SPI:
  SPI.begin();
  SPI.setDataMode(SPI_MODE0);
  SPI.setClockDivider(SPI_CLOCK_DIV2);
  SPI.setBitOrder(MSBFIRST);
  
  PORTC = B0001111;
  PORTD = B10100000;
}

void loop() {
   
}

void timing(){
   //Runs when falling edge from Schmitt Trigger is seen
   check = digitalRead(2);   // This is mucho importante
   if(0 != check){
    return;  
   }
   for (i=96+128; i<256; i++) {
        LEDWrite();
   }
   for (i=0; i<96+128; i++) {
        LEDWrite();
   }
   PORTD = B10100000;
}

void LEDWrite() {
  PORTD = 0b10100000;
  SPI.transfer(dat[i].outer);
  SPI.transfer(dat[i].outer2);
  SPI.transfer(dat[i].inner2);
  SPI.transfer(dat[i].inner);
  PORTD = 0b11100000;
  //delayMicroseconds(59);
  PORTD = 0b00100000;
  delayMicroseconds(118); 
}
