lylemoffitt/Sr-Design/Project Materials/Arduino Programming Materials/SPI_LED_hello_world_rounded/SPI_LED_hello_world_rounded.ino

//#define COUNTER
#define FLICKER

// include the SPI library:
#include <SPI.h>

// set pin 10 as the slave select for the digital pot:
  const int slaveSelectPin = 10;

struct fin { byte lsb,msb; };

const static fin data[] = 
{
  {0x00,0x00}, // 0
  {0x77,0x00}, // 1
  {0x88,0x80}, // 2
  {0x88,0x80}, // 3
  {0x88,0x80}, // 4
  {0x80,0x80}, // 5
  {0x80,0x80}, // 6
  {0x00,0x00}, // 7
  {0x00,0x00}, // 8
  {0x07,0x00}, // 9
  {0x08,0x80}, // 10
  {0x08,0x80}, // 11
  {0x08,0x80}, // 12
  {0x08,0x80}, // 13
  {0x08,0x80}, // 14
  {0xFF,0x00}, // 15
  {0x00,0x00}, // 16
  {0x00,0x00}, // 17
  {0xFF,0x80}, // 18
  {0x80,0x00}, // 19
  {0x80,0x00}, // 20
  {0x80,0x00}, // 21
  {0x80,0x00}, // 22
  {0x80,0x00}, // 23
  {0xFF,0x80}, // 24
  {0x00,0x00}, // 25
  {0x00,0x00}, // 26
  {0x7F,0x00}, // 27
  {0x80,0x80}, // 28
  {0x80,0x80}, // 29
  {0x80,0x80}, // 30
  {0x80,0x80}, // 31
  {0x80,0x80}, // 32
  {0x7F,0x00}, // 33
  {0x00,0x00}, // 34
  {0x00,0x00}, // 35
  {0xF7,0x00}, // 36
  {0x08,0x80}, // 37
  {0x08,0x80}, // 38
  {0x08,0x80}, // 39
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
}; 

unsigned i = 0;

void setup() {
  //pinMode(out_en_pin, OUTPUT);      // sets the digital pin as output
  // set the slaveSelectPin as an output:
  pinMode (slaveSelectPin, OUTPUT);
  attachInterrupt(1,timing,FALLING);
  DDRD = 0xF3;
  // initialize SPI:
  SPI.begin();
  SPI.setClockDivider(SPI_CLOCK_DIV2);
  SPI.setBitOrder(LSBFIRST);
}

void loop() {
   
}

void timing(){
   //Runs when falling edge from Schmitt Trigger is seen
   for (i=0; i<256; ++i) {
       LEDWrite(data[i]);
   }
}

void LEDWrite( struct fin dat ) {
  PORTD = 0b00000000;
  SPI.transfer(dat.msb);
  SPI.transfer(dat.lsb);
  delayMicroseconds(122);
  PORTD = 0b10000000;  
}
