lylemoffitt/Sr-Design/Project Materials/Arduino Programming Materials/SPI_LED_tank/SPI_LED_tank.ino

//#define COUNTER
#define FLICKER

// include the SPI library:
#include <SPI.h>

// set pin 10 as the slave select for the digital pot:
  const int slaveSelectPin = 10;

struct fin { byte lsb,msb; };

const static fin data[] =
{
  {0x00,0x00}, // 0
  {0x00,0x00}, // 1
  {0x00,0x00}, // 2
  {0x00,0x00}, // 3
  {0x00,0x00}, // 4
  {0x00,0x00}, // 5
  {0x00,0x00}, // 6
  {0x00,0x00}, // 7
  {0x00,0x00}, // 8
  {0x00,0x00}, // 9
  {0x00,0x00}, // 10
  {0x00,0x00}, // 11
  {0x00,0x00}, // 12
  {0x00,0x00}, // 13
  {0x00,0x00}, // 14
  {0x00,0x00}, // 15
  {0x00,0x00}, // 16
  {0x00,0x00}, // 17
  {0x00,0x00}, // 18
  {0x00,0x00}, // 19
  {0x00,0x00}, // 20
  {0x00,0x00}, // 21
  {0x00,0x00}, // 22
  {0x00,0x00}, // 23
  {0x00,0x00}, // 24
  {0x00,0x00}, // 25
  {0x00,0x00}, // 26
  {0x00,0x00}, // 27
  {0x00,0x00}, // 28
  {0x00,0x00}, // 29
  {0x00,0x00}, // 30
  {0x00,0x00}, // 31
  {0x00,0x00}, // 32
  {0x00,0x00}, // 33
  {0x00,0x00}, // 34
  {0x00,0x00}, // 35
  {0x00,0x00}, // 36
  {0x00,0x00}, // 37
  {0x00,0x00}, // 38
  {0x00,0x00}, // 39
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
}; 

unsigned i = 0;
unsigned j = 0;
const static fin bullet[] = {{0x20},{0x00}};

void setup() {
  // initialize Pins
  pinMode (slaveSelectPin, OUTPUT);
  attachInterrupt(1,timing,FALLING);
  DDRD = 0xF3;
  // initialize SPI:
  SPI.begin();
  SPI.setClockDivider(SPI_CLOCK_DIV2);
  SPI.setBitOrder(LSBFIRST);
}

void loop() {
   
}

void timing(){
   //Runs when falling edge from Schmitt Trigger is seen
   for (i=0; i<256; ++i) {
     if(i!=j){LEDWrite(data[i]);}
     else{LEDWrite(bullet[0]);}
   }
   if(j<171){++j;}
   else if(j==171){j=201;}
   else if(j<256){++j;}
   else{j=0;}  
}

void LEDWrite( struct fin dat ) {
  PORTD = 0b00000000;
  SPI.transfer(dat.msb);
  SPI.transfer(dat.lsb);
  delayMicroseconds(122);
  PORTD = 0b10000000;  
}
