lylemoffitt/Sr-Design/Project Materials/Arduino Programming Materials/TANK/Tank_1/Tank_1.ino

// include the SPI library:
#include <SPI.h>

struct fin { byte outer,outer2,inner2,inner; };
byte check = 0;
const static fin dat[] = 
{
   //0b_0000_0100, 0b_0000_0000, 0b_0000_0000, 0b0000_0000
   //     0    4       0    0         0   0        0    0
  {0x00,0x00,0x00,0x00},{0x00,0x00,0x00,0x00},{0x00,0x00,0x00,0x00},{0x00,0x00,0x00,0x00},{0x00,0x00,0x00,0x00},{0x00,0x00,0x00,0x00},{0x00,0x00,0x00,0x00},{0x00,0x00,0x00,0x00}, // 0-7
  {0x00,0x00,0x00,0x00},{0x00,0x00,0x00,0x00},{0x00,0x00,0x00,0x00},{0x00,0x00,0x00,0x00},{0x00,0x00,0x00,0x00},{0x00,0x00,0x00,0x00},{0x00,0x00,0x00,0x00},{0x00,0x00,0x00,0x00}, // 8-15
  {0x00,0x00,0x00,0x00},{0x00,0x00,0x00,0x00},{0x00,0x00,0x00,0x00},{0x00,0x00,0x00,0x00},{0x00,0x00,0x00,0x00},{0x00,0x00,0x00,0x00},{0x00,0x00,0x00,0x00},{0x00,0x00,0x00,0x00}, // 16-23
  {0x00,0x00,0x00,0x00},{0x00,0x00,0x00,0x00},{0x00,0x00,0x00,0x00},{0x00,0x00,0x00,0x00},{0x00,0x00,0x00,0x00},{0x00,0x00,0x00,0x00},{0x00,0x00,0x00,0x00},{0x00,0x00,0x00,0x00}, // 24-31   
  {0x00,0x00,0x00,0x00},{0x00,0x00,0x00,0x00},{0x00,0x00,0x00,0x00},{0x00,0x00,0x00,0x00},{0x00,0x00,0x00,0x00},{0x00,0x00,0x00,0x00},{0x00,0x00,0x00,0x00},{0x00,0x00,0x00,0x00}, // 32-39
  {0x00,0x00,0x00,0x00},{0x00,0x00,0x00,0x00},{0x00,0x00,0x00,0x00},{0x00,0x00,0x00,0x00},{0x00,0x00,0x00,0x00},{0x00,0x00,0x00,0x00},{0x00,0x00,0x00,0x00},{0x00,0x00,0x00,0x00}, // 40-47
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
  {0x00,0x00,0x00,0x00},{0x00,0x00,0x00,0x00},{0x00,0x00,0x00,0x00},{0x00,0x00,0x00,0x00},{0x00,0x00,0x00,0x00},{0x00,0x00,0x00,0x00},{0x00,0x00,0x00,0x00},{0x00,0x00,0x00,0x00}, // 224-231
  {0x00,0x00,0x00,0x00},{0x00,0x00,0x00,0x00},{0x00,0x00,0x00,0x00},{0x00,0x00,0x00,0x00},{0x00,0x00,0x00,0x00},{0x00,0x00,0x00,0x00},{0x00,0x00,0x00,0x00},{0x00,0x00,0x00,0x00}, // 232-239
  {0x00,0x00,0x00,0x00},{0x00,0x00,0x00,0x00},{0x00,0x00,0x00,0x00},{0x00,0x00,0x00,0x00},{0x00,0x00,0x00,0x00},{0x00,0x00,0x00,0x00},{0x00,0x00,0x00,0x00},{0x00,0x00,0x00,0x00}, // 240-247
  {0x00,0x00,0x00,0x00},{0x00,0x00,0x00,0x00},{0x00,0x00,0x00,0x00},{0x00,0x00,0x00,0x00},{0x00,0x00,0x00,0x00},{0x00,0x00,0x00,0x00},{0x00,0x00,0x00,0x00},{0x00,0x00,0x00,0x00}, // 248-255
};

volatile unsigned i = 0;

void setup() {
  // Initialize I/O
  DDRC = DDRC | B0111111;
  DDRD = DDRD | B11111000;
  attachInterrupt(0,timing,FALLING);
  // initialize SPI:
  SPI.begin();
  SPI.setDataMode(SPI_MODE0);
  SPI.setClockDivider(SPI_CLOCK_DIV2);
  SPI.setBitOrder(MSBFIRST);
  
  PORTC = B0001111;
  PORTD = B10100000;
}

void loop() {
   
}

void timing(){
   //Runs when falling edge from Schmitt Trigger is seen
   check = digitalRead(2);   // This is mucho importante
   if(0 != check){
    return;  
   }
   for (i=96+128; i<256; i++) {
        LEDWrite();
   }
   for (i=0; i<96+128; i++) {
        LEDWrite();
   }
   PORTD = B10100000;
}

void LEDWrite() {
  PORTD = 0b10100000;
  SPI.transfer(dat[i].outer);
  SPI.transfer(dat[i].outer2);
  SPI.transfer(dat[i].inner2);
  SPI.transfer(dat[i].inner);
  PORTD = 0b11100000;
  //delayMicroseconds(59);
  PORTD = 0b00100000;
  delayMicroseconds(118); 
}
