lylemoffitt/Sr-Design/Sr-Design/Sr-Design/main.cpp

//
//  main.cpp
//  Sr-Design
//
//  Created by Lyle Moffitt on 11/17/14.
//  Copyright (c) 2014 Lyle Moffitt. All rights reserved.
//

#include <iostream>
#include "ring-buffer.h"

int main(int argc, const char * argv[])
{

    // insert code here...
    std::cout << "Hello, World!\n";
    return 0;
}
