lylemoffitt/Sr-Design/Project Materials/Arduino Programming Materials/SD_test/SD_ctrl.h

/*
 * SD_ctrl.h
 *
 *  Created on: Feb 1, 2015
 *      Author: Lyle
 */

#ifndef SD_CTRL_H_
#define SD_CTRL_H_

/* Arduino Sd2Card Library
 * Copyright (C) 2012 by William Greiman
 *
 * This file is part of the Arduino Sd2Card Library
 *
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
 * You should have received a copy of the GNU General Public License
 * along with the Arduino Sd2Card Library.  If not, see
 * <http://www.gnu.org/licenses/>.
 */

#include <stdint.h>
// Based on the document:
//
// SD Specifications
// Part 1
// Physical Layer
// Simplified Specification
// Version 3.01
// May 18, 2010
//
// http://www.sdcard.org/developers/tech/sdcard/pls/simplified_specs

//------------------------------------------------------------------------------
// SPI divisor constants
/** Set SCK to max rate of F_CPU/2. */
uint8_t const SPI_FULL_SPEED = 2;
/** Set SCK rate to F_CPU/3 for Due */
uint8_t const SPI_DIV3_SPEED = 3;
/** Set SCK rate to F_CPU/4. */
uint8_t const SPI_HALF_SPEED = 4;
/** Set SCK rate to F_CPU/6 for Due */
uint8_t const SPI_DIV6_SPEED = 6;
/** Set SCK rate to F_CPU/8. */
uint8_t const SPI_QUARTER_SPEED = 8;
/** Set SCK rate to F_CPU/16. */
uint8_t const SPI_EIGHTH_SPEED = 16;
/** Set SCK rate to F_CPU/32. */
uint8_t const SPI_SIXTEENTH_SPEED = 32;

//------------------------------------------------------------------------------
// SD operation timeouts
/** init timeout ms */
uint16_t const SD_INIT_TIMEOUT = 2000;
/** erase timeout ms */
uint16_t const SD_ERASE_TIMEOUT = 10000;
/** read timeout ms */
uint16_t const SD_READ_TIMEOUT = 300;
/** write time out ms */
uint16_t const SD_WRITE_TIMEOUT = 600;

//------------------------------------------------------------------------------
// SD card commands
/** GO_IDLE_STATE - init card in spi mode if CS low */
uint8_t const CMD0 = 0X00;
/** SEND_IF_COND - verify SD Memory Card interface operating condition.*/
uint8_t const CMD8 = 0X08;
/** SEND_CSD - read the Card Specific Data (CSD register) */
uint8_t const CMD9 = 0X09;
/** SEND_CID - read the card identification information (CID register) */
uint8_t const CMD10 = 0X0A;
/** STOP_TRANSMISSION - end multiple block read sequence */
uint8_t const CMD12 = 0X0C;
/** SEND_STATUS - read the card status register */
uint8_t const CMD13 = 0X0D;
/** READ_SINGLE_BLOCK - read a single data block from the card */
uint8_t const CMD17 = 0X11;
/** READ_MULTIPLE_BLOCK - read a multiple data blocks from the card */
uint8_t const CMD18 = 0X12;
/** WRITE_BLOCK - write a single data block to the card */
uint8_t const CMD24 = 0X18;
/** WRITE_MULTIPLE_BLOCK - write blocks of data until a STOP_TRANSMISSION */
uint8_t const CMD25 = 0X19;
/** ERASE_WR_BLK_START - sets the address of the first block to be erased */
uint8_t const CMD32 = 0X20;
/** ERASE_WR_BLK_END - sets the address of the last block of the continuous range to be erased*/
uint8_t const CMD33 = 0X21;
/** ERASE - erase all previously selected blocks */
uint8_t const CMD38 = 0X26;
/** APP_CMD - escape for application specific command */
uint8_t const CMD55 = 0X37;
/** READ_OCR - read the OCR register of a card */
uint8_t const CMD58 = 0X3A;
/** CRC_ON_OFF - enable or disable CRC checking */
uint8_t const CMD59 = 0X3B;
/** SET_WR_BLK_ERASE_COUNT - Set the number of write blocks to be pre-erased before writing */
uint8_t const ACMD23 = 0X17;
/** SD_SEND_OP_COMD - Sends host capacity support information and activates the card's initialization process */
uint8_t const ACMD41 = 0X29;

//------------------------------------------------------------------------------
/** status for card in the ready state */
uint8_t const R1_READY_STATE = 0X00;
/** status for card in the idle state */
uint8_t const R1_IDLE_STATE = 0X01;
/** status bit for illegal command */
uint8_t const R1_ILLEGAL_COMMAND = 0X04;
/** start data token for read or write single block*/
uint8_t const DATA_START_BLOCK = 0XFE;
/** stop token for write multiple blocks*/
uint8_t const STOP_TRAN_TOKEN = 0XFD;
/** start data token for write multiple blocks*/
uint8_t const WRITE_MULTIPLE_TOKEN = 0XFC;
/** mask for data response tokens after a write block operation */
uint8_t const DATA_RES_MASK = 0X1F;
/** write data accepted token */
uint8_t const DATA_RES_ACCEPTED = 0X05;

//------------------------------------------------------------------------------
/** Card IDentification (CID) register */
typedef struct CID {
  // byte 0
  /** Manufacturer ID */
  byte mid;
  // byte 1-2
  /** OEM/Application ID */
  char oid[2];
  // byte 3-7
  /** Product name */
  char pnm[5];
  // byte 8
  /** Product revision least significant digit */
  byte prv_m : 4;
  /** Product revision most significant digit */
  byte prv_n : 4;
  // byte 9-12
  /** Product serial number */
  uint32_t psn;
  // byte 13
  /** Manufacturing date year low digit */
  byte mdt_year_high : 4;
  /** not used */
  byte reserved : 4;
  // byte 14
  /** Manufacturing date month */
  byte mdt_month : 4;
  /** Manufacturing date year low digit */
  byte mdt_year_low :4;
  // byte 15
  /** not used always 1 */
  byte always1 : 1;
  /** CRC7 checksum */
  byte crc : 7;
}__attribute__((packed)) cid_t;

//------------------------------------------------------------------------------
/** CSD for version 1.00 cards */
typedef struct CSDV1 {
  // byte 0
  byte reserved1 : 6;
  byte csd_ver : 2;
  // byte 1
  byte taac;
  // byte 2
  byte nsac;
  // byte 3
  byte tran_speed;
  // byte 4
  byte ccc_high;
  // byte 5
  byte read_bl_len : 4;
  byte ccc_low : 4;
  // byte 6
  byte c_size_high : 2;
  byte reserved2 : 2;
  byte dsr_imp : 1;
  byte read_blk_misalign :1;
  byte write_blk_misalign : 1;
  byte read_bl_partial : 1;
  // byte 7
  byte c_size_mid;
  // byte 8
  byte vdd_r_curr_max : 3;
  byte vdd_r_curr_min : 3;
  byte c_size_low :2;
  // byte 9
  byte c_size_mult_high : 2;
  byte vdd_w_cur_max : 3;
  byte vdd_w_curr_min : 3;
  // byte 10
  byte sector_size_high : 6;
  byte erase_blk_en : 1;
  byte c_size_mult_low : 1;
  // byte 11
  byte wp_grp_size : 7;
  byte sector_size_low : 1;
  // byte 12
  byte write_bl_len_high : 2;
  byte r2w_factor : 3;
  byte reserved3 : 2;
  byte wp_grp_enable : 1;
  // byte 13
  byte reserved4 : 5;
  byte write_partial : 1;
  byte write_bl_len_low : 2;
  // byte 14
  byte reserved5: 2;
  byte file_format : 2;
  byte tmp_write_protect : 1;
  byte perm_write_protect : 1;
  byte copy : 1;
  /** Indicates the file format on the card */
  byte file_format_grp : 1;
  // byte 15
  byte always1 : 1;
  byte crc : 7;
}__attribute__((packed)) csd1_t;

//------------------------------------------------------------------------------
/** CSD for version 2.00 cards */
typedef struct CSDV2 {
  // byte 0
  byte reserved1 : 6;
  byte csd_ver : 2;
  // byte 1
  /** fixed to 0X0E */
  byte taac;
  // byte 2
  /** fixed to 0 */
  byte nsac;
  // byte 3
  byte tran_speed;
  // byte 4
  byte ccc_high;
  // byte 5
  /** This field is fixed to 9h, which indicates READ_BL_LEN=512 Byte */
  byte read_bl_len : 4;
  byte ccc_low : 4;
  // byte 6
  /** not used */
  byte reserved2 : 4;
  byte dsr_imp : 1;
  /** fixed to 0 */
  byte read_blk_misalign :1;
  /** fixed to 0 */
  byte write_blk_misalign : 1;
  /** fixed to 0 - no partial read */
  byte read_bl_partial : 1;
  // byte 7
  /** high part of card size */
  byte c_size_high : 6;
  /** not used */
  byte reserved3 : 2;
  // byte 8
  /** middle part of card size */
  byte c_size_mid;
  // byte 9
  /** low part of card size */
  byte c_size_low;
  // byte 10
  /** sector size is fixed at 64 KB */
  byte sector_size_high : 6;
  /** fixed to 1 - erase single is supported */
  byte erase_blk_en : 1;
  /** not used */
  byte reserved4 : 1;
  // byte 11
  byte wp_grp_size : 7;
  /** sector size is fixed at 64 KB */
  byte sector_size_low : 1;
  // byte 12
  /** write_bl_len fixed for 512 byte blocks */
  byte write_bl_len_high : 2;
  /** fixed value of 2 */
  byte r2w_factor : 3;
  /** not used */
  byte reserved5 : 2;
  /** fixed value of 0 - no write protect groups */
  byte wp_grp_enable : 1;
  // byte 13
  byte reserved6 : 5;
  /** always zero - no partial block read*/
  byte write_partial : 1;
  /** write_bl_len fixed for 512 byte blocks */
  byte write_bl_len_low : 2;
  // byte 14
  byte reserved7: 2;
  /** Do not use always 0 */
  byte file_format : 2;
  byte tmp_write_protect : 1;
  byte perm_write_protect : 1;
  byte copy : 1;
  /** Do not use always 0 */
  byte file_format_grp : 1;
  // byte 15
  /** not used always 1 */
  byte always1 : 1;
  /** checksum */
  byte crc : 7;
}__attribute__((packed)) csd2_t;

//------------------------------------------------------------------------------
/** union of old and new style CSD register */
union csd_t {
  csd1_t v1;
  csd2_t v2;
};


#endif /* SD_CTRL_H_ */
